zgtk-guri/c-pro-micro/schematic_rev3.pdf

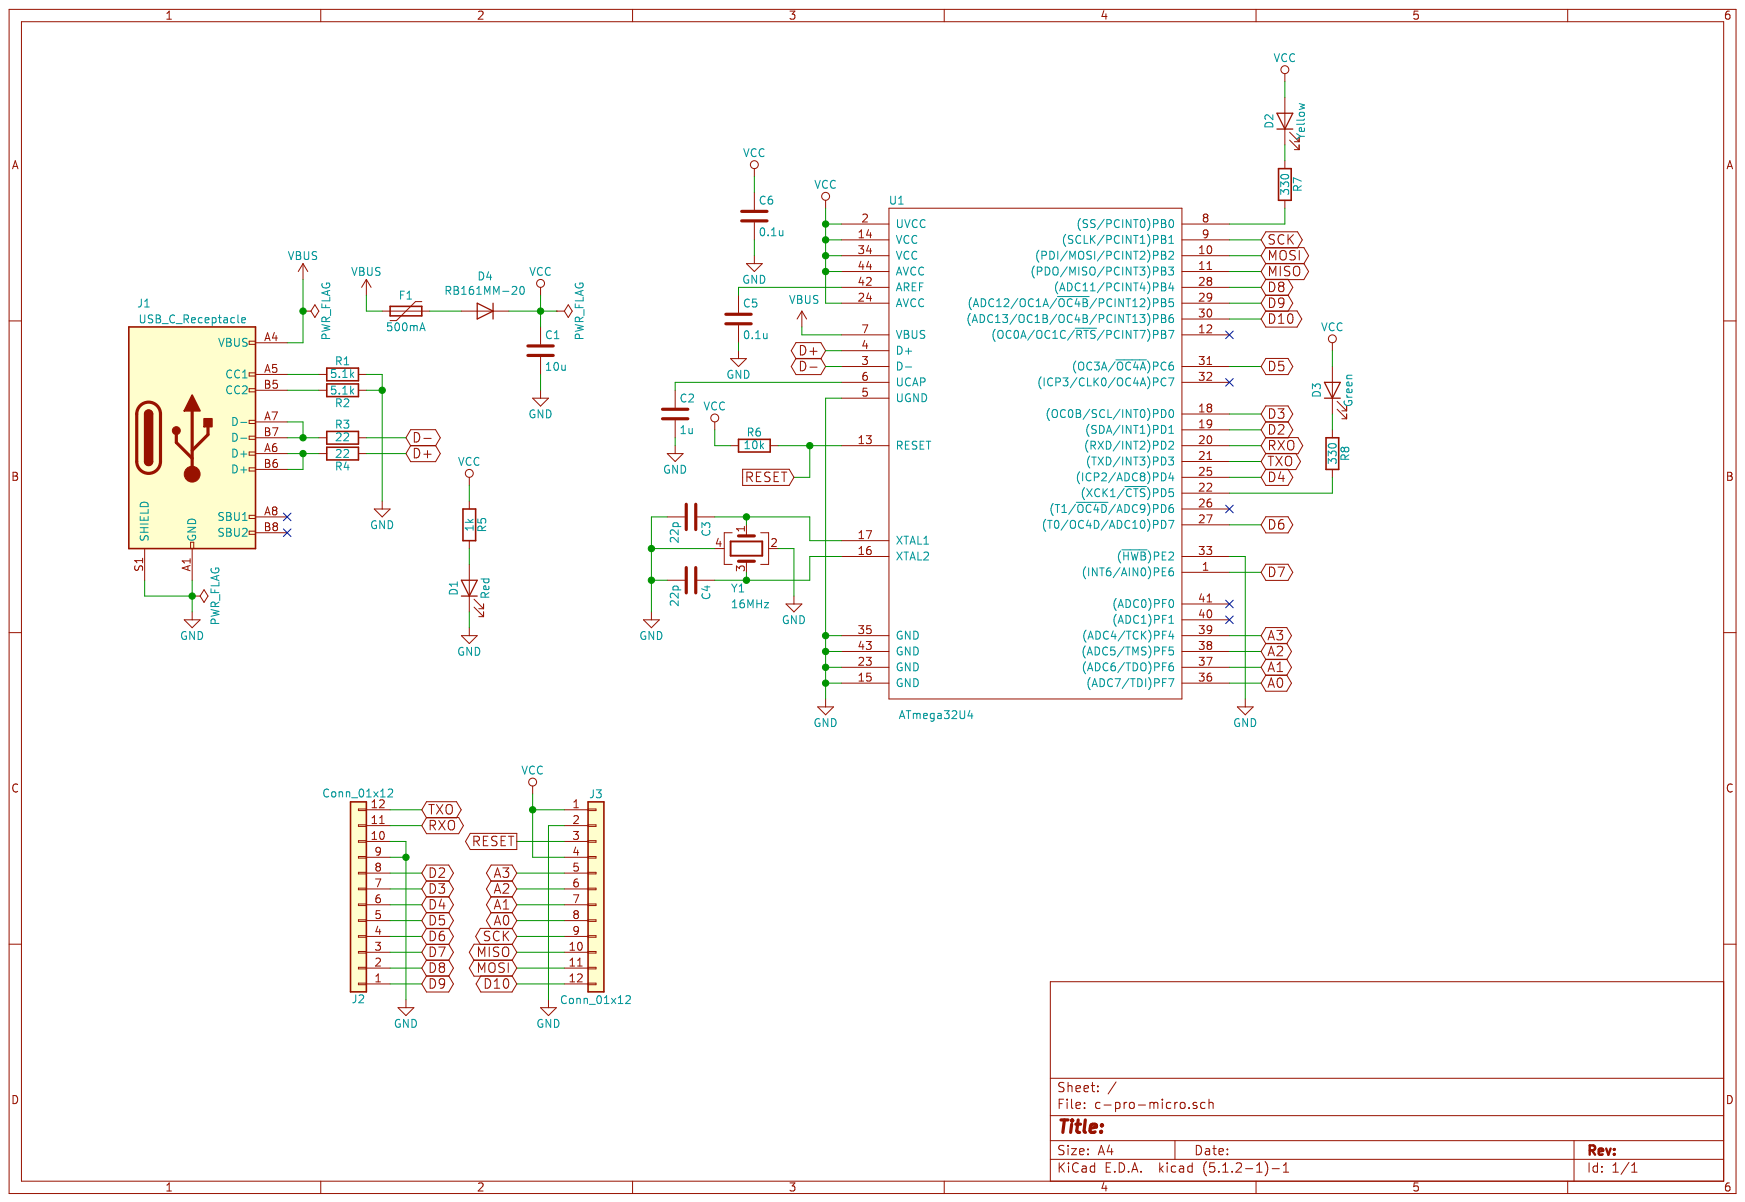
[picture p1: page 1]
