zgtk-guri/c-pro-micro/c-pro-micro.kicad_pcb

## KiCad design c-pro-micro.kicad_pcb (2020-08-15)

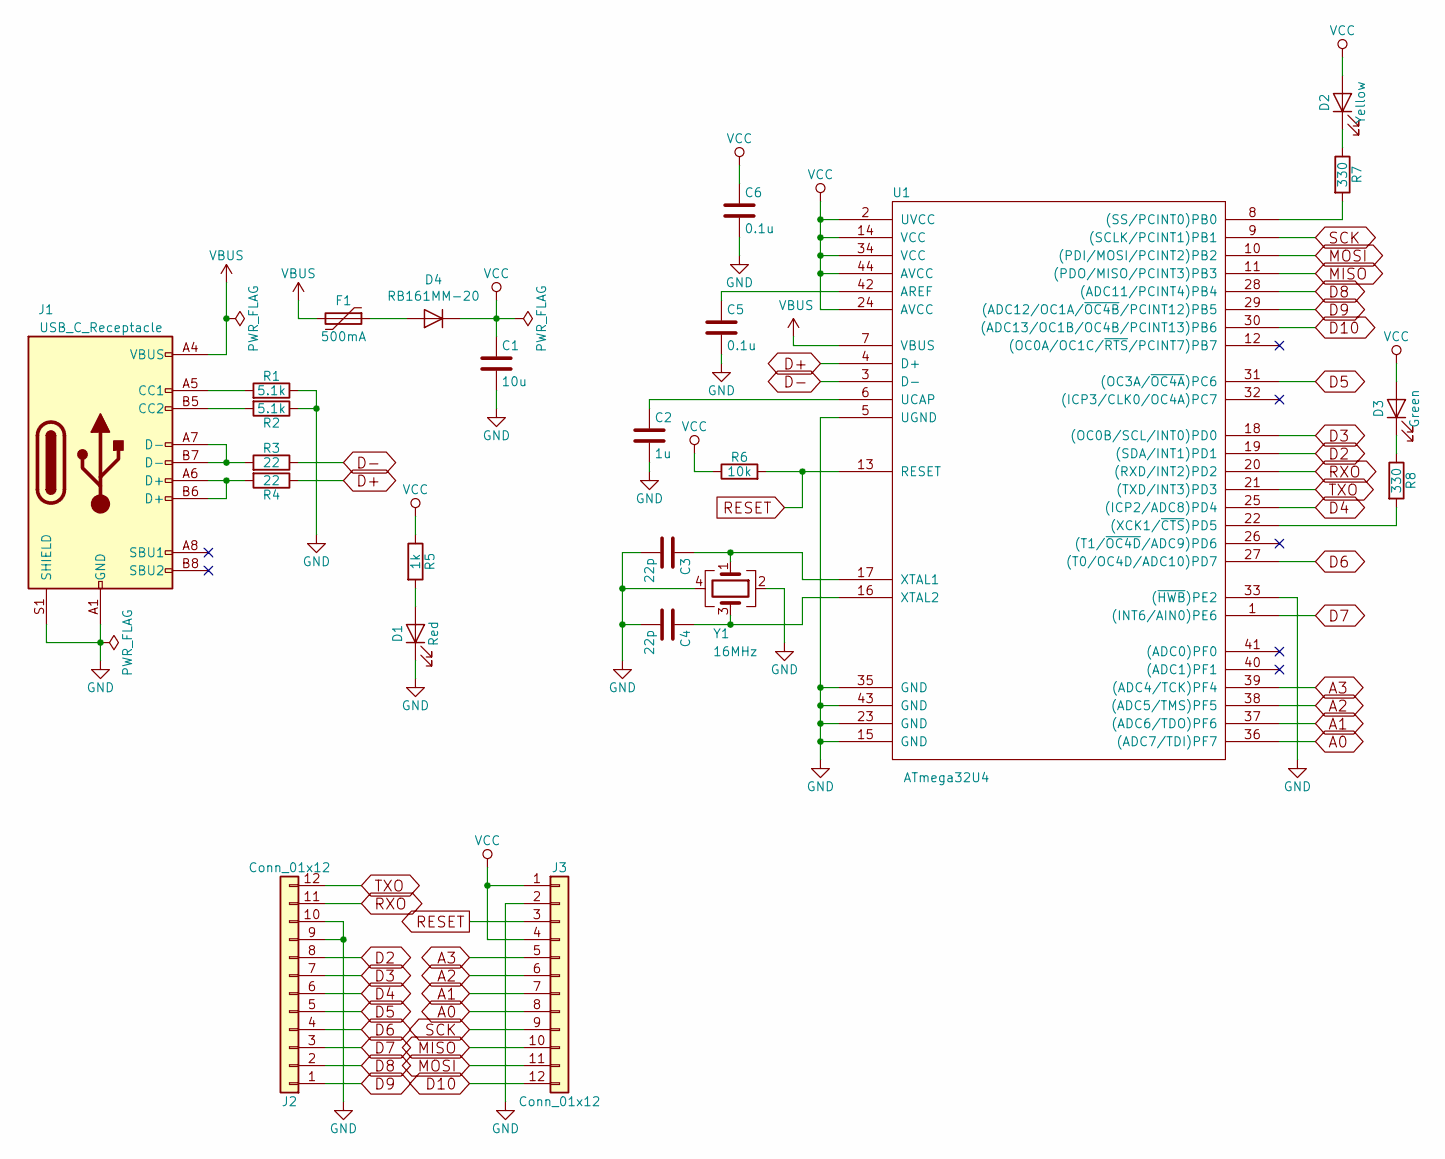
[picture p2: schematic c-pro-micro.sch]

Parts:
C1: 10u; C_0603_1608Metric; MPN CL10A106KP8NNNC
C2: 1u; C_0402_1005Metric
C3, C4: 22p; C_0402_1005Metric; MPN 0402CG220J500NT
C5, C6: 0.1u; C_0402_1005Metric; MPN CL05B104KO5NNNC
D1: Red; LED_0603_1608Metric
D2: Yellow; LED_0603_1608Metric
D3: Green; LED_0603_1608Metric
D4: RB161MM-20; D_SOD-123F
F1: 500mA; Fuse_1206_3216Metric
J1: USB_C_Receptacle; CX90M-16P; MPN CX90M-16P; DigikeyPN H126318CT-ND
J2: Conn_01x12; ProMicro_LeftPinhead
J3: Conn_01x12; ProMicro_RightPinhead
R1, R2: 5.1k; R_0402_1005Metric; MPN 0603WAF5101T5E
R3, R4: 22; R_0402_1005Metric; MPN 0402WGF220JTCE
R5: 1k; R_0402_1005Metric; MPN 0402WGF1001TCE
R6: 10k; R_0402_1005Metric; MPN 0402WGF1002TCE
R7, R8: 330; R_0402_1005Metric
U1: ATmega32U4; QFN-44-1EP_7x7mm_Pitch0.5mm_without_bottom; MPN ATMEGA32U4-MUR; DigikeyPN ATMEGA32U4-MURCT-ND
Y1: 16MHz; Crystal_SMD_SeikoEpson_FA238-4Pin_3.2x2.5mm; MPN FA-238 16.0000MB-C3; DigikeyPN SER3686CT-ND

Connections:
A0: J3.8, U1.36 ((ADC7/TDI)PF7)
A1: J3.7, U1.37 ((ADC6/TDO)PF6)
A2: J3.6, U1.38 ((ADC5/TMS)PF5)
A3: J3.5, U1.39 ((ADC4/TCK)PF4)
D2: J2.8, U1.19 ((SDA/INT1)PD1)
D3: J2.7, U1.18 ((OC0B/SCL/INT0)PD0)
D4: J2.6, U1.25 ((ICP2/ADC8)PD4)
D5: J2.5, U1.31 ((OC3A/~OC4A~)PC6)
D6: J2.4, U1.27 ((T0/OC4D/ADC10)PD7)
D7: J2.3, U1.1 ((INT6/AIN0)PE6)
D8: J2.2, U1.28 ((ADC11/PCINT4)PB4)
D9: J2.1, U1.29 ((ADC12/OC1A/~OC4B~/PCINT12)PB5)
D10: J3.12, U1.30 ((ADC13/OC1B/OC4B/PCINT13)PB6)
D+: R4.1, U1.4 (D+)
D-: R3.1, U1.3 (D-)
GND: C1.2, C2.2, C3.2, C4.2, C5.2, C6.2, D1.1 (K), J1.A1 (GND), J1.A12 (GND), J1.B1 (GND), J1.B12 (GND), J1.S1 (SHIELD), J2.9, J2.10, J3.2, R1.1, R2.1, U1.5 (UGND), U1.15 (GND), U1.23 (GND), U1.33 ((~HWB~)PE2), U1.35 (GND), U1.43 (GND), Y1.2, Y1.4
MISO: J3.10, U1.11 ((PDO/MISO/PCINT3)PB3)
MOSI: J3.11, U1.10 ((PDI/MOSI/PCINT2)PB2)
unnamed: C2.1, U1.6 (UCAP)
unnamed: C3.1, U1.17 (XTAL1), Y1.1
unnamed: C4.1, U1.16 (XTAL2), Y1.3
unnamed: C5.1, U1.42 (AREF)
unnamed: D1.2 (A), R5.2
unnamed: D2.1 (K), R7.1
unnamed: D3.1 (K), R8.1
unnamed: D4.2 (A), F1.1
unnamed: J1.A5 (CC1), R1.2
unnamed: J1.A6 (D+), J1.B6 (D+), R4.2
unnamed: J1.A7 (D-), J1.B7 (D-), R3.2
unnamed: J1.B5 (CC2), R2.2
unnamed: R7.2, U1.8 ((SS/PCINT0)PB0)
unnamed: R8.2, U1.22 ((XCK1/~CTS~)PD5)
RESET: J3.3, R6.2, U1.13 (RESET)
RXO: J2.11, U1.20 ((RXD/INT2)PD2)
SCK: J3.9, U1.9 ((SCLK/PCINT1)PB1)
TXO: J2.12, U1.21 ((TXD/INT3)PD3)
VBUS: F1.2, J1.A4 (VBUS), J1.A9 (VBUS), J1.B4 (VBUS), J1.B9 (VBUS), U1.7 (VBUS)
VCC: C1.1, C6.1, D2.2 (A), D3.2 (A), D4.1 (K), J3.1, J3.4, R5.1, R6.1, U1.2 (UVCC), U1.14 (VCC), U1.24 (AVCC), U1.34 (VCC), U1.44 (AVCC)

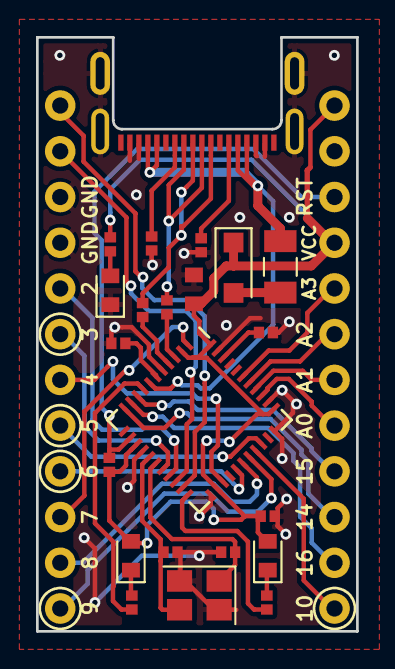
[picture p3: board c-pro-micro.kicad_pcb from above]

Board: 2 copper layers, 17.8 x 33.0 mm, 24 parts (0 on the bottom side), 38 nets.
