zgtk-guri/c-pro-micro/(commit log)

2018-04-25 Create KiCad project and add schematic
    [c-pro-micro.kicad_pcb, c-pro-micro.sch]
2018-04-29 add parts informations
    [c-pro-micro.sch]
2018-04-30 Change components footprint
    [c-pro-micro.sch]
2018-04-30 Add pcb
    [c-pro-micro.kicad_pcb]
2018-05-04 add schematic
2019-01-27 change through hole diameter to 0.9mm
    [c-pro-micro.kicad_pcb]
